23333ironnnnn/intelligent-air-chair/photos/3d81e667c90c068492d7e599e2e6d553.jpg

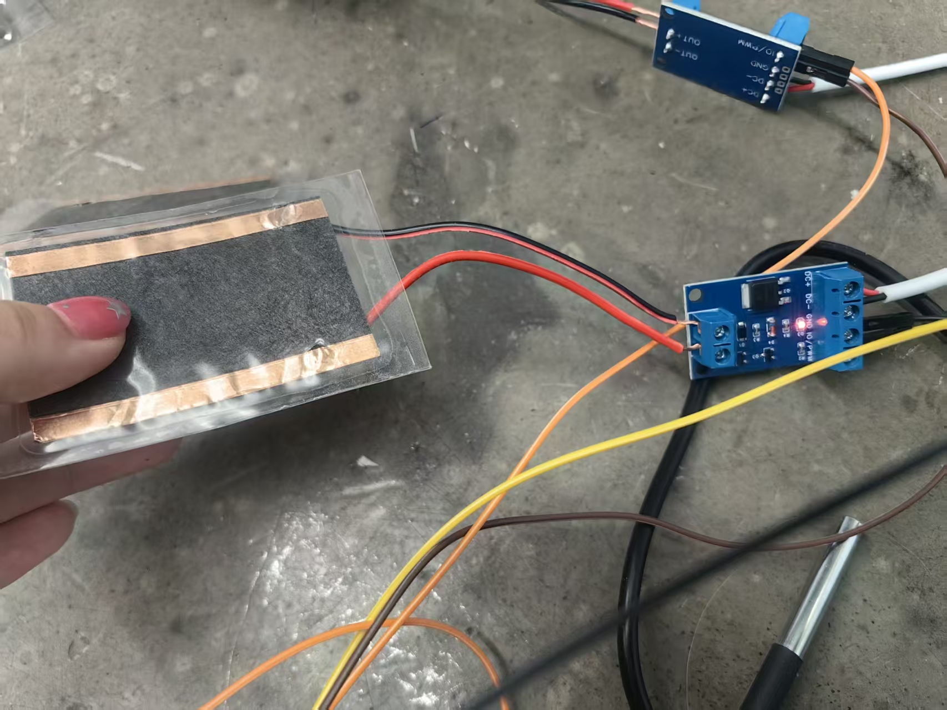
photos/3d81e667c90c068492d7e599e2e6d553.jpg
