23333ironnnnn/intelligent-air-chair/photos/82c75ddc46648b1e27fe5249b13b2717.jpg

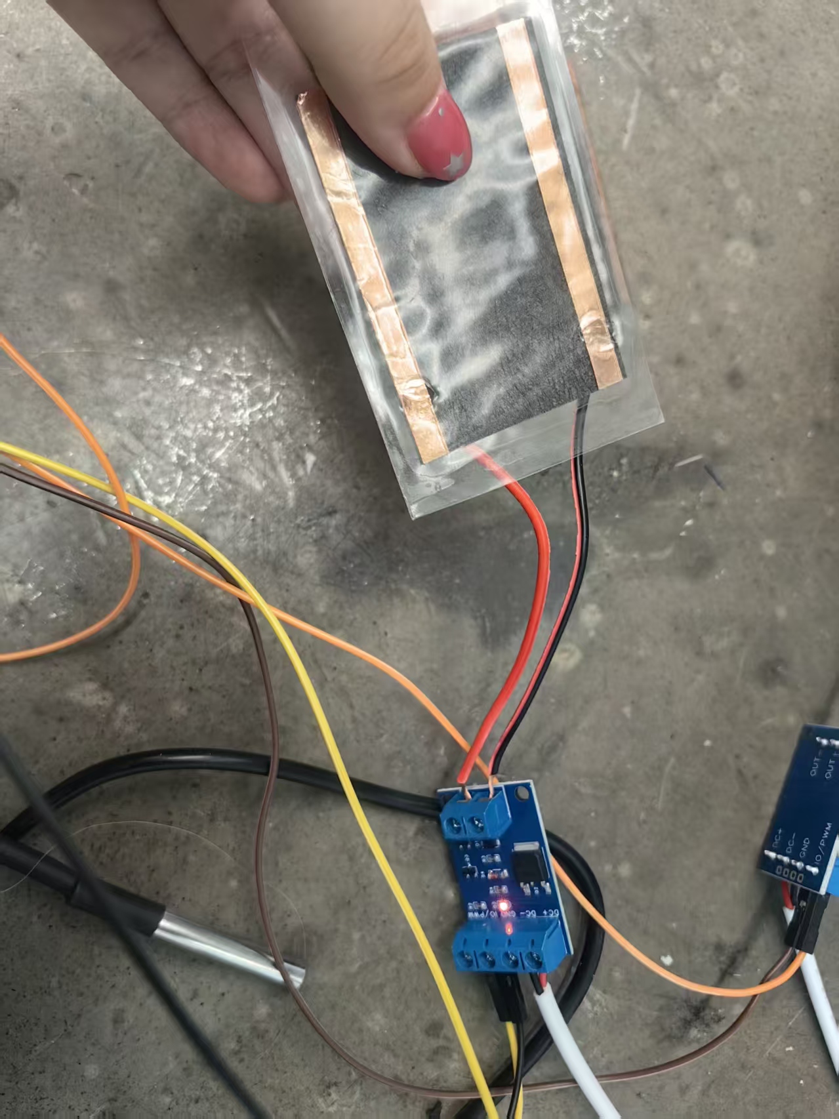
photos/82c75ddc46648b1e27fe5249b13b2717.jpg
