23333ironnnnn/intelligent-air-chair/photos/155ff54e559d4409a2b7c3d6302aa020.jpg

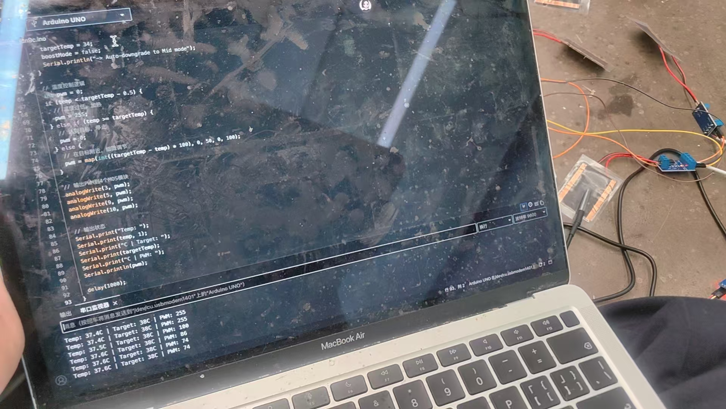
photos/155ff54e559d4409a2b7c3d6302aa020.jpg
