23333ironnnnn/intelligent-air-chair/photos/498bb9c75d1ef36b5d2631e4a2f4800a.jpg

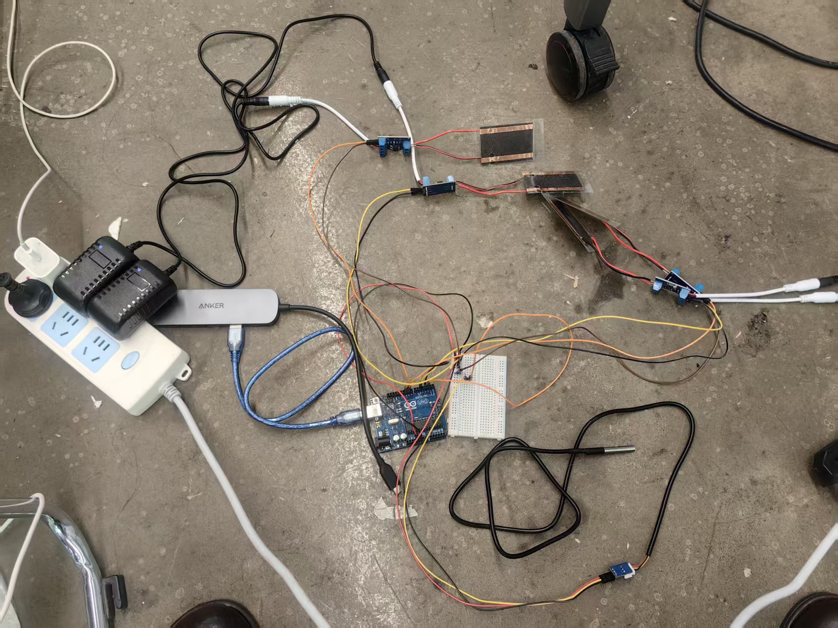
photos/498bb9c75d1ef36b5d2631e4a2f4800a.jpg
