23333ironnnnn/intelligent-air-chair/photos/截屏2026-06-09 14.15.55.png

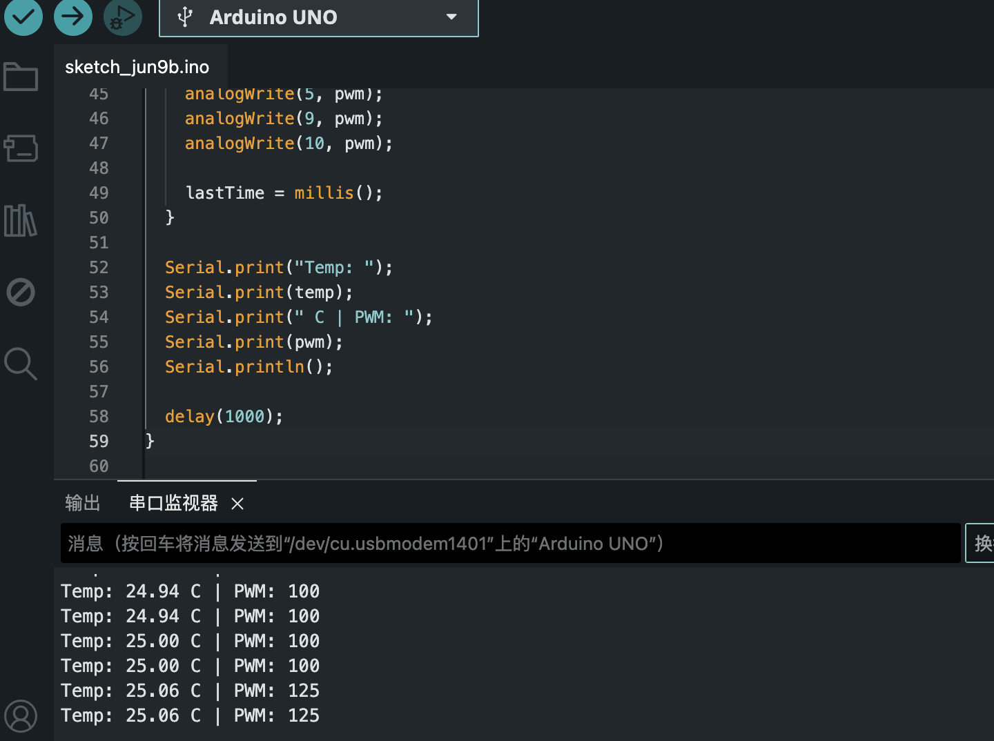
photos/截屏2026-06-09 14.15.55.png
