23333ironnnnn/intelligent-air-chair/(commit log)

2026-06-07 [feat] Add DS18B20 temperature sensor test
2026-06-09 [feat] Three-level temperature control working - 30C/34C/38C modes tested and stable
2026-06-09 [feat] Add three-level temperature control (30C/34C/38C)
2026-06-09 [feat] Add touchscreen UI for ESP32-3248S035R (CYD 3.5")
    - Visual temperature display + touch mode switching (30/34/38C)
    - Replaces Serial-command control from 02; keeps same control logic
    - ST7796U display + XPT2046 resistive touch via LovyanGFX
    - DS18B20 -> IO25, 4x MOS heater (paralleled) -> IO32
    - Onboard RGB LED as mode indicator (blue/green/red)
    - Pins verified against official lcdwiki datasheet
    - Add 00_screen_test.ino smoke test
    - Add docs: requirements + step-by-step guide (Chinese)
    [00_screen_test.ino, 03_touchscreen_ui.ino]
2026-06-09 [feat] Touchscreen UI tested on real hardware + draggable slider
    - Verified on actual ESP32-3248S035R: display, touch, upload all OK
    - Fix display invert (false) — black bg + correct RGB confirmed on device
    - Fix color888->color565 (24-bit value was truncated, navy showed green)
    - Redesign bottom control as draggable slider with 3 snap stops (30/34/38)
    - drag handle, live preview bubble, snap-to-nearest on release
    - Aviation white/navy theme, FreeSans vector fonts
    - Move sketches into per-sketch folders (Arduino standard layout)
    [00_screen_test.ino, 03_touchscreen_ui.ino]
2026-06-11 [feat] Add OFF stop to slider + verified heating on hardware
    - Slider now has 4 stops: OFF / 30 / 34 / 38 (OFF is leftmost)
    - OFF: PWM forced 0, RGB LED off, status shows OFF, bubble shows OFF
    - Default to OFF on boot (safer for a seat heater)
    - Heating control verified end-to-end on real hardware (MOS + heating film)
2026-06-11 [docs] Add verified wiring diagram (接线图.md)
    - ASCII wiring diagram: DS18B20 (IO25) + 4x MOS heater (IO32)
    - Pin mapping table, I2C connector layout
    - 3 safety rules: common ground, isolate positives, sensor on 3.3V
    - Reflects hardware-verified wiring
2026-06-11 Expand README with project details and instructions
    Added detailed project description, features, hardware specifications, wiring overview, project structure, quick start guide, and license information.
2026-06-11 [chore] Clean up repo
    - Remove stale IMPLEMENTATION_CONSTRAINT.md (old Arduino-era plan, superseded)
    - Remove accidental nested 'intelligent air chair/' duplicate folder
    - Untrack .DS_Store files and add .gitignore
